triflicacid/remote-submersible/simulations/electromagnet.asc

D1: diode
D2: diode
L1: ind; 10µ
L2: ind; 10µ
M1: nmos; SiR416DP
M2: nmos; SiR470DP
M3: nmos; SiR470DP
R1: res; 100k
R2: res; 1k
R3: res; 10
V1: voltage; PULSE(0 3.3 0 0 0 0.5 1)
V2: voltage; 3.3
V3: voltage; 6
V4: voltage; PULSE(0 3.3 0 0 0 0.5 1)
Named nets: 0
.tran 0 10 0 0.01
