triflicacid/remote-submersible/schematics/on-board-controller/controller.kicad_pcb

## KiCad design schematics/on-board-controller/controller.kicad_pcb (2024-08-15)

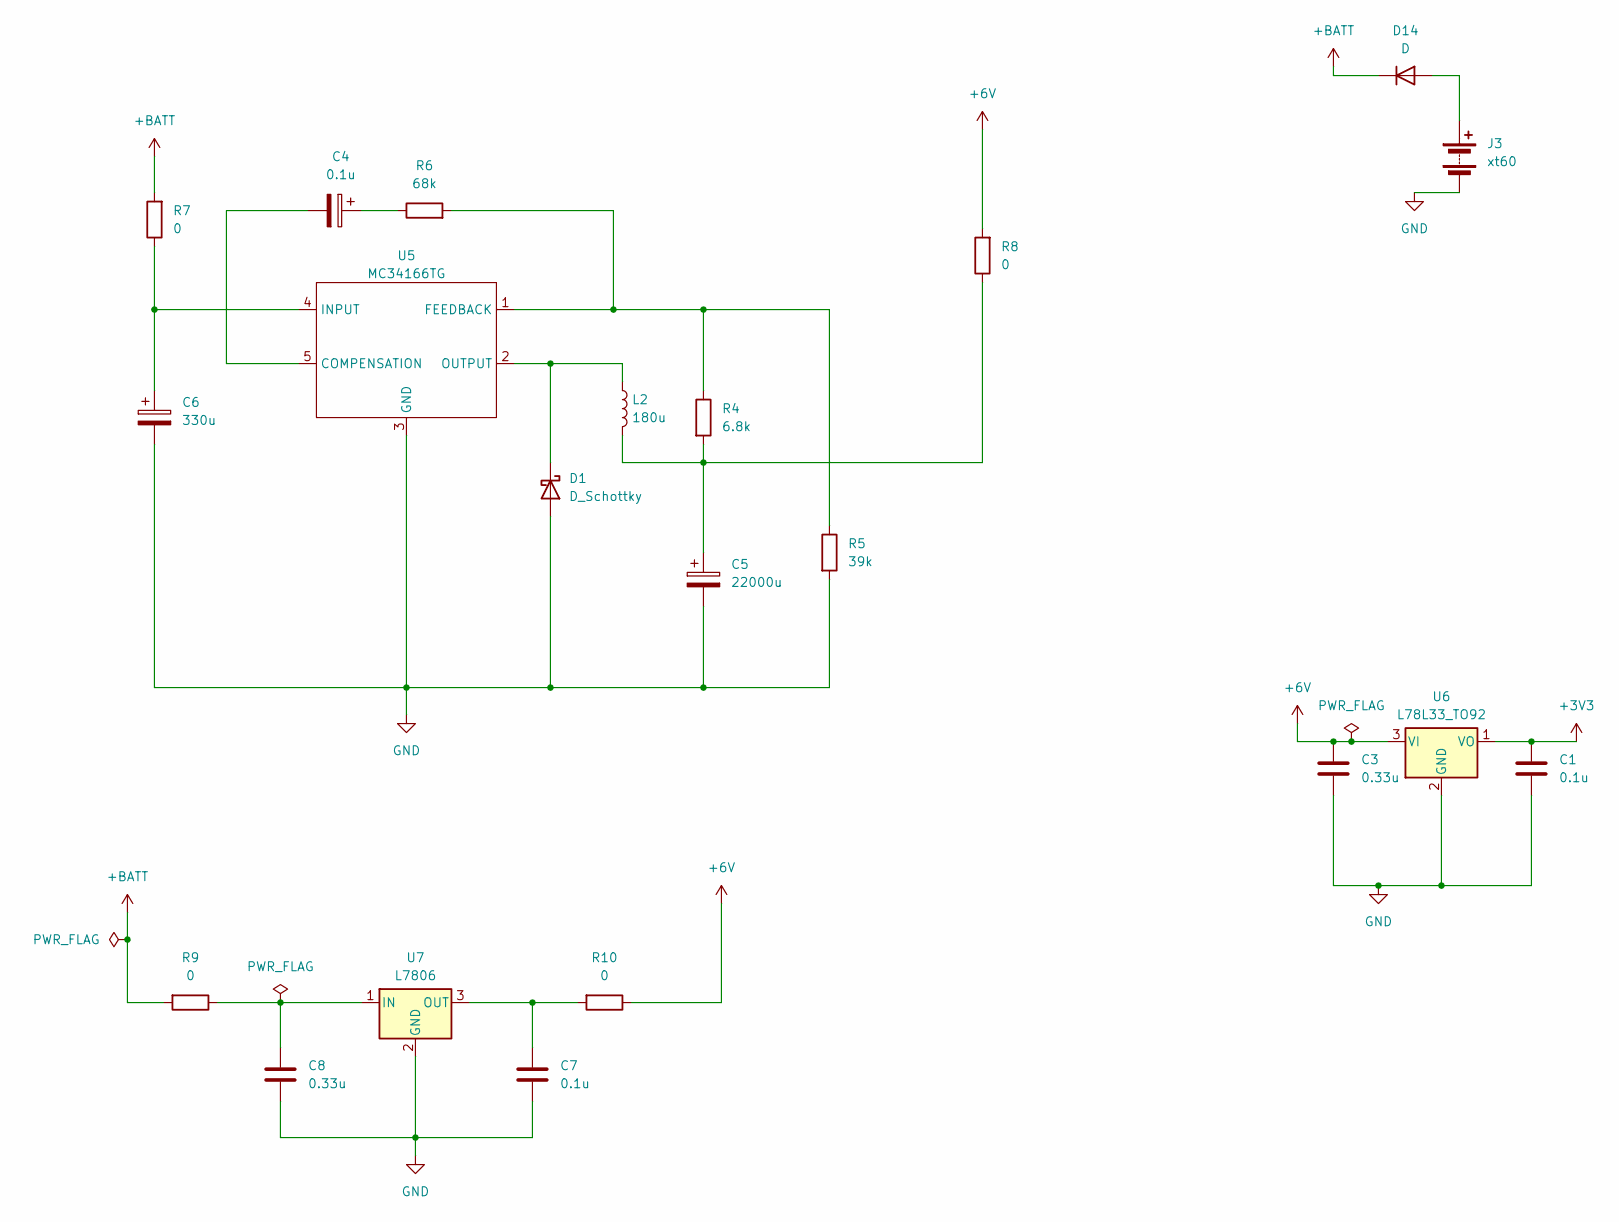
[picture p1: schematic power.kicad_sch, On-board Controller]

Parts:
C1, C7: 0.1u; C_0805_2012Metric_Pad1.18x1.45mm_HandSolder
C3, C8: 0.33u; C_0805_2012Metric_Pad1.18x1.45mm_HandSolder
C4: 0.1u; CP_Radial_D5.0mm_P2.00mm
C5: 22000u; CP_Radial_D18.0mm_P7.50mm
C6: 330u; CP_Radial_D8.0mm_P3.50mm
D1: D_Schottky; D_SOD-128
D14: D; D_A-405_P7.62mm_Horizontal
J3: xt60; PinSocket_1x02_P2.54mm_Vertical
L2: 180u; L_Bourns_SRR1208_12.7x12.7mm
R4: 6.8k; R_0805_2012Metric_Pad1.20x1.40mm_HandSolder
R5: 39k; R_0805_2012Metric_Pad1.20x1.40mm_HandSolder
R6: 68k; R_0805_2012Metric_Pad1.20x1.40mm_HandSolder
R7, R8, R9, R10: 0; R_0805_2012Metric_Pad1.20x1.40mm_HandSolder
U5: MC34166TG; TO-220-5_Vertical
U6: L78L33_TO92; TO-92_Inline
U7: L7806; TO-220-3_Vertical

Connections:
+3V3: C1.1, U6.1 (VO); also elsewhere on the board
+6V: C3.1, R8.2, R10.1, U6.3 (VI); also elsewhere on the board
+BATT: D14.1 (K), R7.2, R9.2; also elsewhere on the board
GND: C1.2, C3.2, C5.2, C6.2, C7.2, C8.2, D1.2 (A), J3.2 (-), R5.2, U5.3 (GND), U6.2 (GND), U7.2 (GND); also elsewhere on the board
unnamed: C4.1, R6.1
unnamed: C5.1, L2.2, R4.2, R8.1
unnamed: D1.1 (K), L2.1, U5.2 (OUTPUT)
unnamed: D14.2 (A), J3.1 (+)
unnamed: C4.2, U5.5 (COMPENSATION)
unnamed: R4.1, R5.1, R6.2, U5.1 (FEEDBACK)
unnamed: C6.1, R7.1, U5.4 (INPUT)
unnamed: C8.1, R9.1, U7.1 (IN)
unnamed: C7.1, R10.2, U7.3 (OUT)

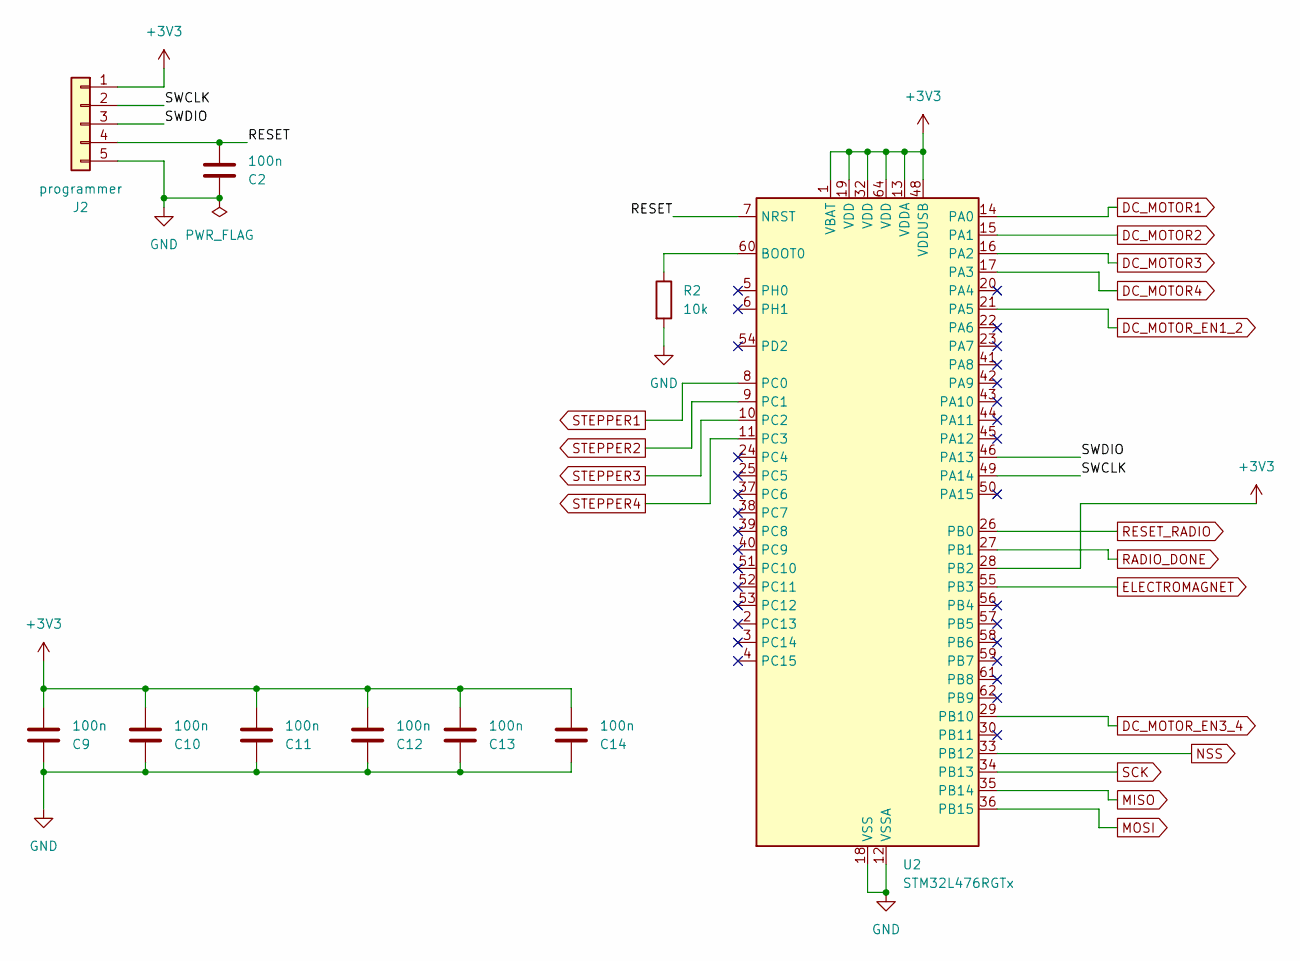
[picture p2: schematic mcu.kicad_sch, On-board Controller]

Parts:
C2, C9, C10, C11, C12, C13, C14: 100n; C_0805_2012Metric_Pad1.18x1.45mm_HandSolder
J2: programmer; PinSocket_1x05_P2.54mm_Vertical
R2: 10k; R_0805_2012Metric_Pad1.20x1.40mm_HandSolder
U2: STM32L476RGTx; LQFP-64_10x10mm_P0.5mm

Connections:
+3V3: C9.2, C10.2, C11.2, C12.2, C13.2, C14.2, J2.1, U2.1 (VBAT), U2.13 (VDDA), U2.19 (VDD), U2.28 (PB2), U2.32 (VDD), U2.48 (VDDUSB), U2.64 (VDD); also elsewhere on the board
/mcu/RESET: C2.2, J2.4, U2.7 (NRST)
/mcu/SWCLK: J2.2, U2.49 (PA14)
/mcu/SWDIO: J2.3, U2.46 (PA13)
DC_MOTOR1: U2.14 (PA0); also elsewhere on the board
DC_MOTOR2: U2.15 (PA1); also elsewhere on the board
DC_MOTOR3: U2.16 (PA2); also elsewhere on the board
DC_MOTOR4: U2.17 (PA3); also elsewhere on the board
DC_MOTOR_EN1_2: U2.21 (PA5); also elsewhere on the board
DC_MOTOR_EN3_4: U2.29 (PB10); also elsewhere on the board
ELECTROMAGNET: U2.55 (PB3); also elsewhere on the board
GND: C2.1, C9.1, C10.1, C11.1, C12.1, C13.1, C14.1, J2.5, R2.2, U2.12 (VSSA), U2.18 (VSS), U2.31 (VSS), U2.47 (VSS), U2.63 (VSS); also elsewhere on the board
MISO: U2.35 (PB14); also elsewhere on the board
MOSI: U2.36 (PB15); also elsewhere on the board
NSS: U2.33 (PB12); also elsewhere on the board
unnamed: R2.1, U2.60 (BOOT0)
RADIO_DONE: U2.27 (PB1); also elsewhere on the board
RESET_RADIO: U2.26 (PB0); also elsewhere on the board
SCK: U2.34 (PB13); also elsewhere on the board
STEPPER1: U2.8 (PC0); also elsewhere on the board
STEPPER2: U2.9 (PC1); also elsewhere on the board
STEPPER3: U2.10 (PC2); also elsewhere on the board
STEPPER4: U2.11 (PC3); also elsewhere on the board

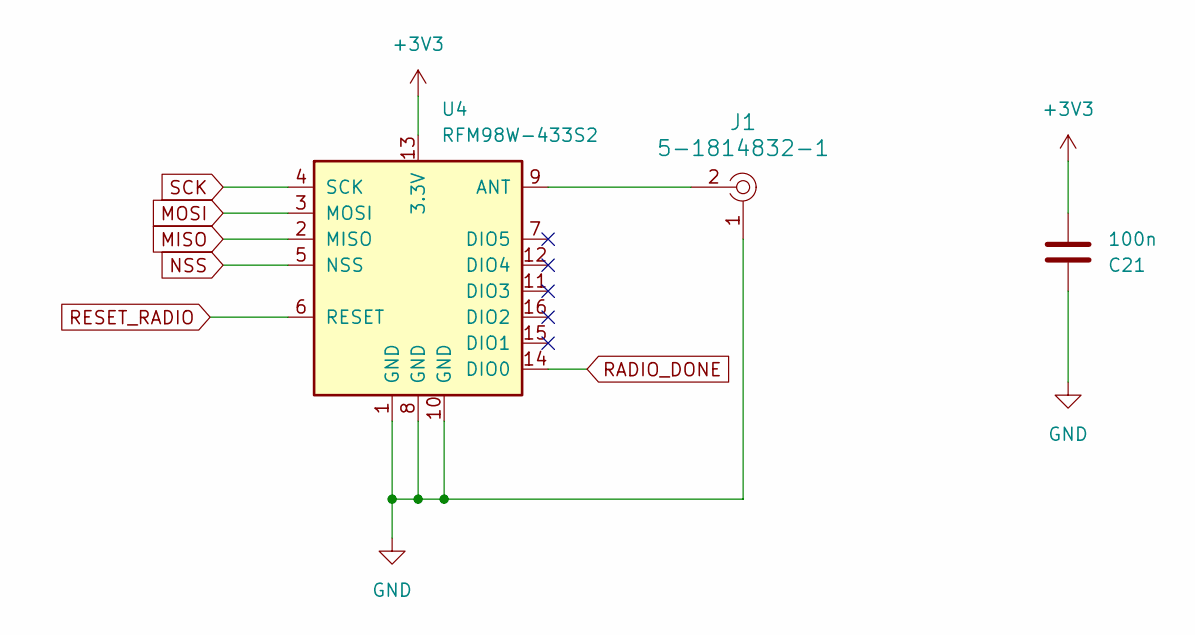
[picture p3: schematic radio.kicad_sch, On-board Controller]

Parts:
C21: 100n; C_0805_2012Metric_Pad1.18x1.45mm_HandSolder
J1: 5-1814832-1; RF_SMA_Vertical_5-1814832-1; MPN 5-1814832-1; Digi-Key_PN A97594-ND
U4: RFM98W-433S2; HOPERF_RFM9XW_THT

Connections:
+3V3: C21.2, U4.13 (3.3V); also elsewhere on the board
GND: C21.1, J1.1, U4.1 (GND), U4.8 (GND), U4.10 (GND); also elsewhere on the board
MISO: U4.2 (MISO); also elsewhere on the board
MOSI: U4.3 (MOSI); also elsewhere on the board
NSS: U4.5 (NSS); also elsewhere on the board
unnamed: J1.2, U4.9 (ANT)
RADIO_DONE: U4.14 (DIO0); also elsewhere on the board
RESET_RADIO: U4.6 (RESET); also elsewhere on the board
SCK: U4.4 (SCK); also elsewhere on the board

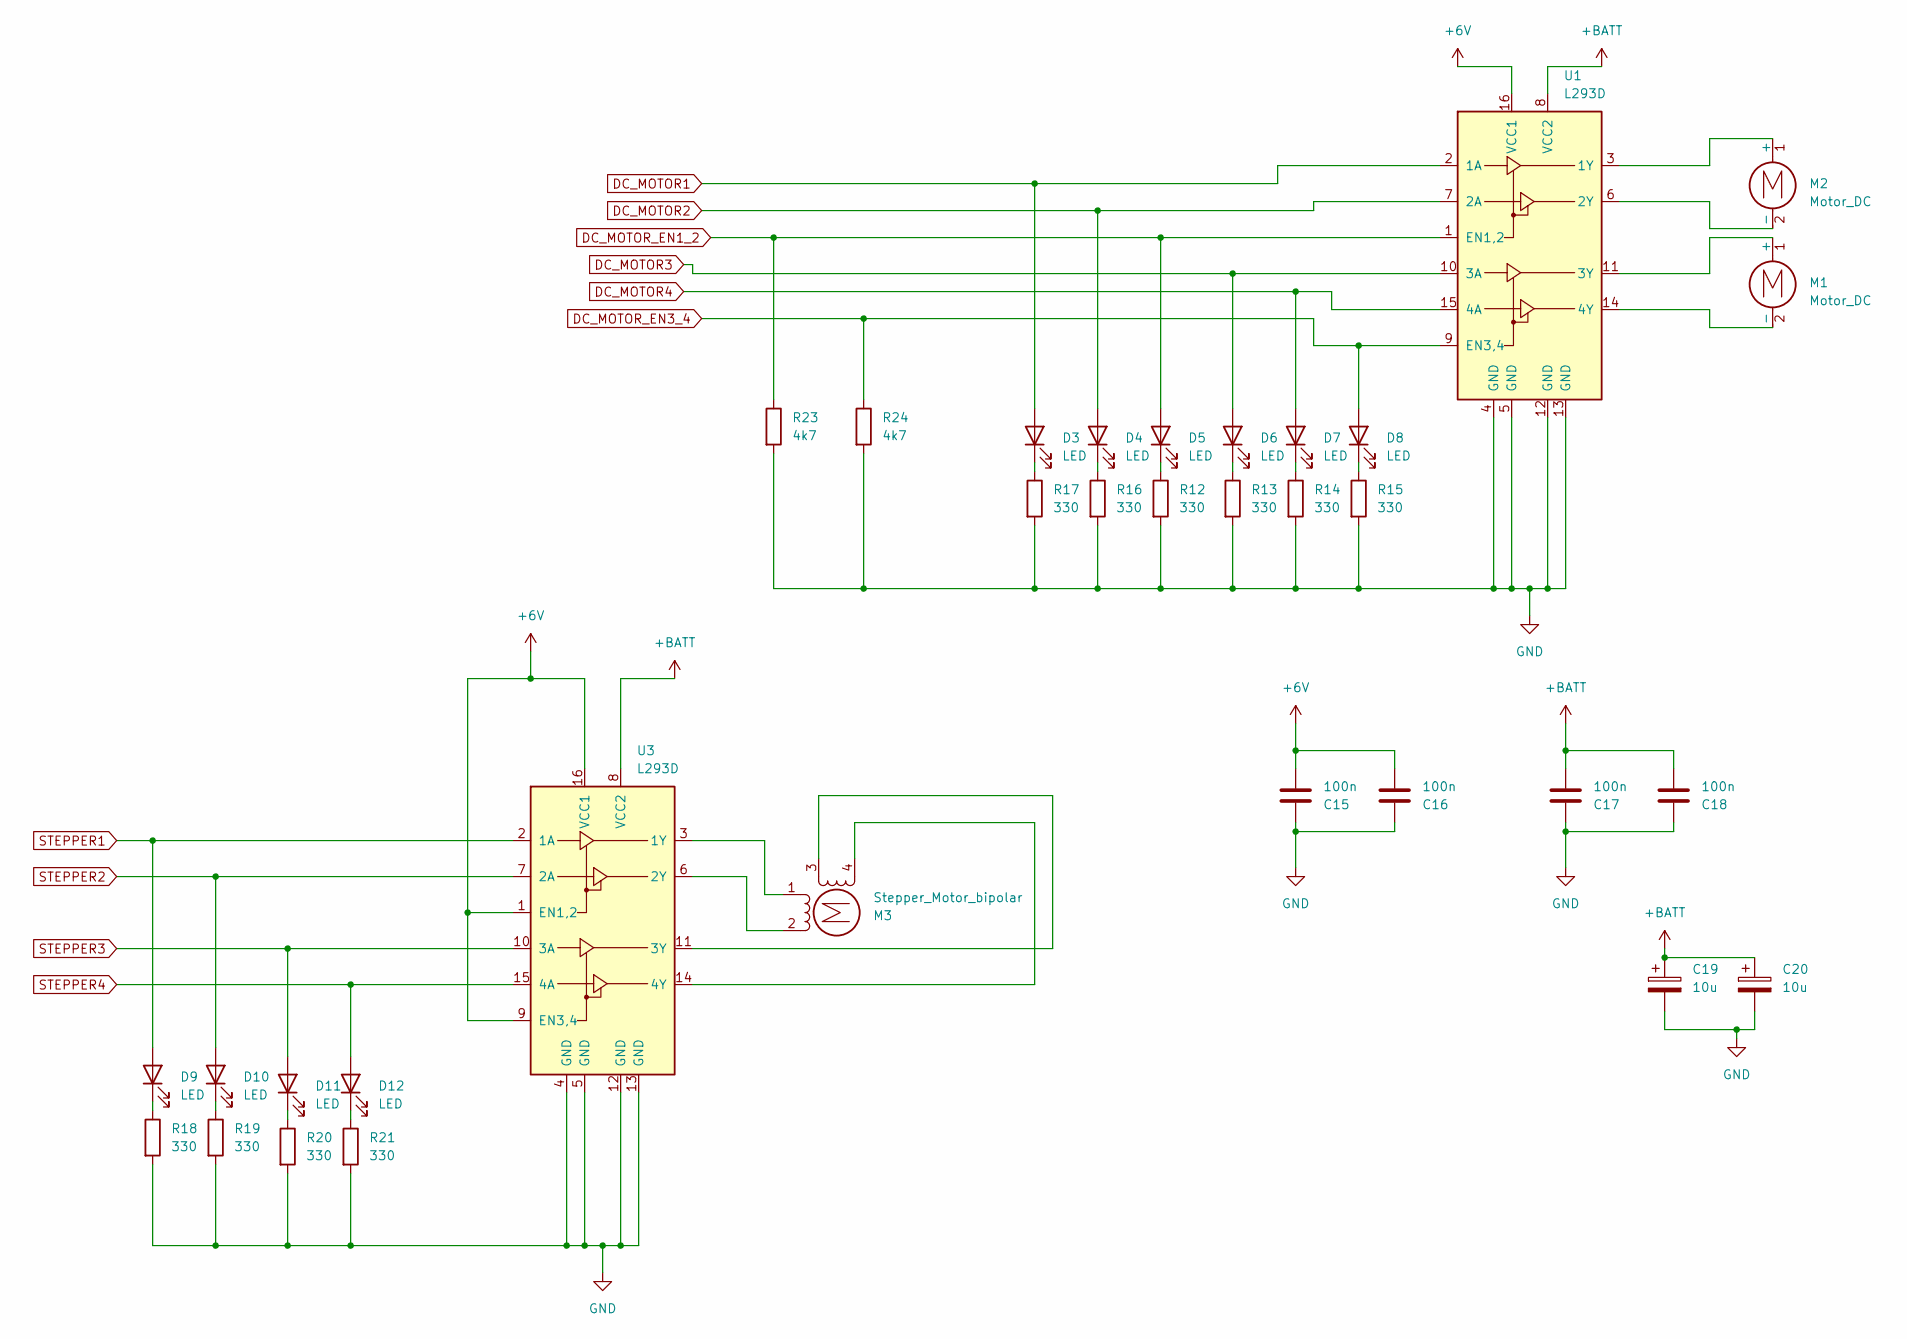
[picture p4: schematic motor.kicad_sch, On-board Controller]

Parts:
C15, C16, C17, C18: 100n; C_0805_2012Metric_Pad1.18x1.45mm_HandSolder
C19, C20: 10u; CP_Radial_D5.0mm_P2.00mm
D3, D4, D5, D6, D7, D8, D9, D10, D11, D12: LED; LED_0805_2012Metric_Pad1.15x1.40mm_HandSolder
M1, M2: Motor_DC; TerminalBlock_Xinya_XY308-2.54-2P_1x02_P2.54mm_Horizontal
M3: Stepper_Motor_bipolar; PinSocket_1x04_P2.54mm_Vertical
R12, R13, R14, R15, R16, R17, R18, R19, R20, R21: 330; R_0805_2012Metric_Pad1.20x1.40mm_HandSolder
R23, R24: 4k7; R_0805_2012Metric_Pad1.20x1.40mm_HandSolder
U1, U3: L293D; DIP-16_W7.62mm

Connections:
+6V: C15.2, C16.2, U1.16 (VCC1), U3.1 (EN1,2), U3.9 (EN3,4), U3.16 (VCC1); also elsewhere on the board
+BATT: C17.2, C18.2, C19.1, C20.1, U1.8 (VCC2), U3.8 (VCC2); also elsewhere on the board
DC_MOTOR1: D3.2 (A), U1.2 (1A); also elsewhere on the board
DC_MOTOR2: D4.2 (A), U1.7 (2A); also elsewhere on the board
DC_MOTOR3: D6.2 (A), U1.10 (3A); also elsewhere on the board
DC_MOTOR4: D7.2 (A), U1.15 (4A); also elsewhere on the board
DC_MOTOR_EN1_2: D5.2 (A), R23.1, U1.1 (EN1,2); also elsewhere on the board
DC_MOTOR_EN3_4: D8.2 (A), R24.1, U1.9 (EN3,4); also elsewhere on the board
GND: C15.1, C16.1, C17.1, C18.1, C19.2, C20.2, R12.2, R13.2, R14.2, R15.2, R16.2, R17.2, R18.2, R19.2, R20.2, R21.2, R23.2, R24.2, U1.4 (GND), U1.5 (GND), U1.12 (GND), U1.13 (GND), U3.4 (GND), U3.5 (GND), U3.12 (GND), U3.13 (GND); also elsewhere on the board
unnamed: D3.1 (K), R17.1
unnamed: D4.1 (K), R16.1
unnamed: D5.1 (K), R12.1
unnamed: D6.1 (K), R13.1
unnamed: D7.1 (K), R14.1
unnamed: D8.1 (K), R15.1
unnamed: D9.1 (K), R18.1
unnamed: D10.1 (K), R19.1
unnamed: D11.1 (K), R20.1
unnamed: D12.1 (K), R21.1
unnamed: M1.1 (+), U1.11 (3Y)
unnamed: M1.2 (-), U1.14 (4Y)
unnamed: M2.1 (+), U1.3 (1Y)
unnamed: M2.2 (-), U1.6 (2Y)
unnamed: M3.2 (-), U3.6 (2Y)
unnamed: M3.1, U3.3 (1Y)
unnamed: M3.3, U3.11 (3Y)
unnamed: M3.4, U3.14 (4Y)
STEPPER1: D9.2 (A), U3.2 (1A); also elsewhere on the board
STEPPER2: D10.2 (A), U3.7 (2A); also elsewhere on the board
STEPPER3: D11.2 (A), U3.10 (3A); also elsewhere on the board
STEPPER4: D12.2 (A), U3.15 (4A); also elsewhere on the board

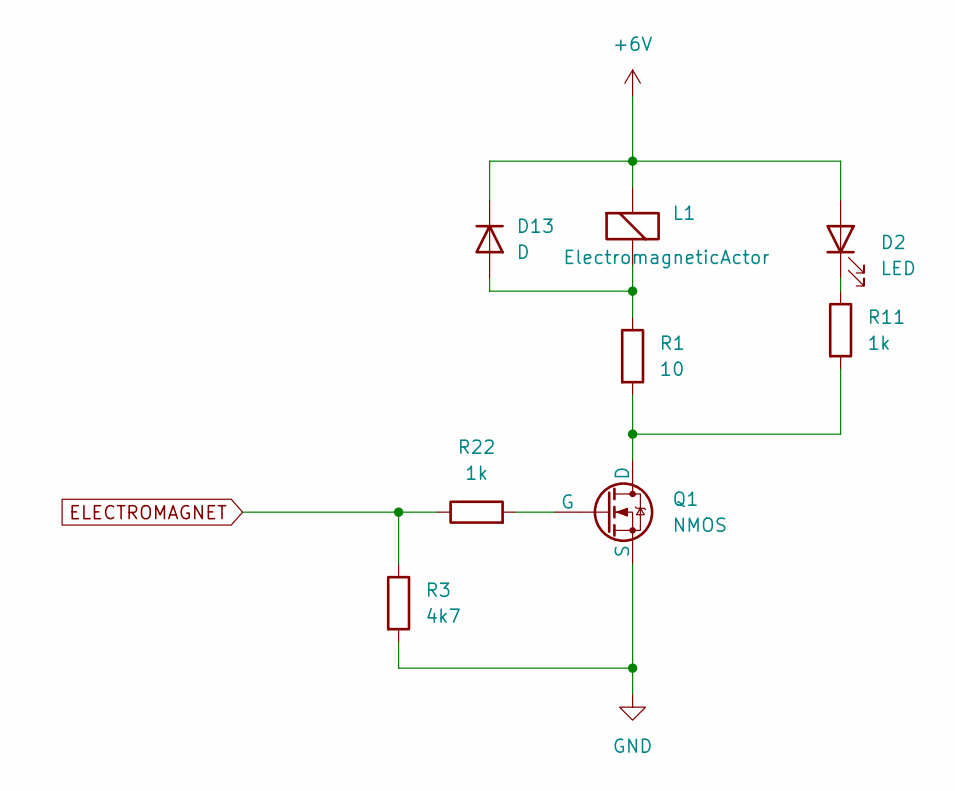
[picture p5: schematic electromagnet.kicad_sch, On-board Controller]

Parts:
D2: LED; LED_0805_2012Metric_Pad1.15x1.40mm_HandSolder
D13: D; D_A-405_P7.62mm_Horizontal
L1: ElectromagneticActor; TerminalBlock_Xinya_XY308-2.54-2P_1x02_P2.54mm_Horizontal
Q1: NMOS; TO-92_Inline
R1: 10; R_0805_2012Metric_Pad1.20x1.40mm_HandSolder
R3: 4k7; R_0805_2012Metric_Pad1.20x1.40mm_HandSolder
R11, R22: 1k; R_0805_2012Metric_Pad1.20x1.40mm_HandSolder

Connections:
+6V: D2.2 (A), D13.1 (K), L1.1 (-); also elsewhere on the board
ELECTROMAGNET: R3.1, R22.1; also elsewhere on the board
GND: Q1.3 (S), R3.2; also elsewhere on the board
unnamed: D2.1 (K), R11.1
unnamed: D13.2 (A), L1.2 (+), R1.1
unnamed: Q1.1 (D), R1.2, R11.2
unnamed: Q1.2 (G), R22.2

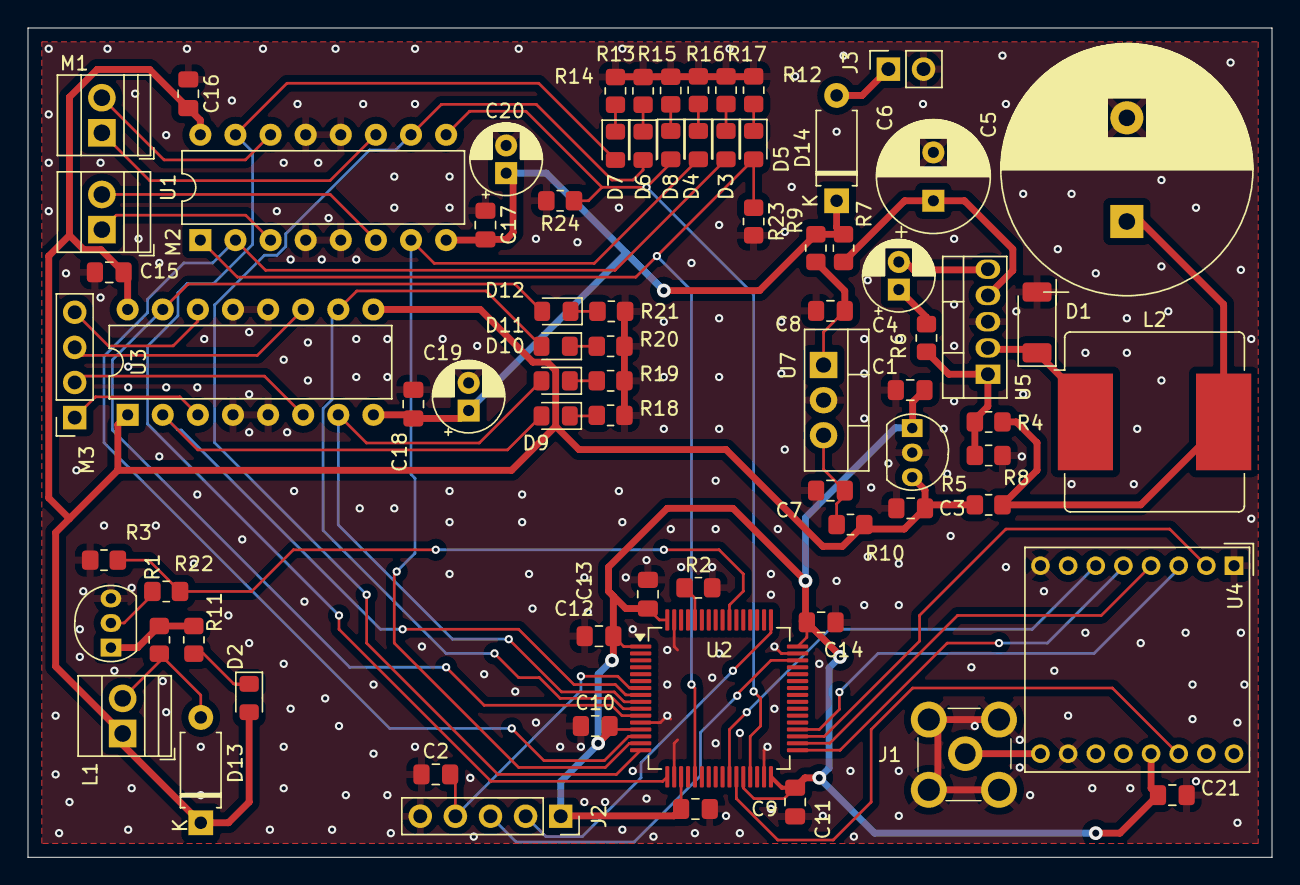
[picture p6: board schematics/on-board-controller/controller.kicad_pcb from above]

Board: 2 copper layers, 90.0 x 60.0 mm, 75 parts (0 on the bottom side), 57 nets.
