triflicacid/remote-submersible/schematics/off-board-controller/controller.kicad_pcb

## KiCad design schematics/off-board-controller/controller.kicad_pcb (2024-08-29)

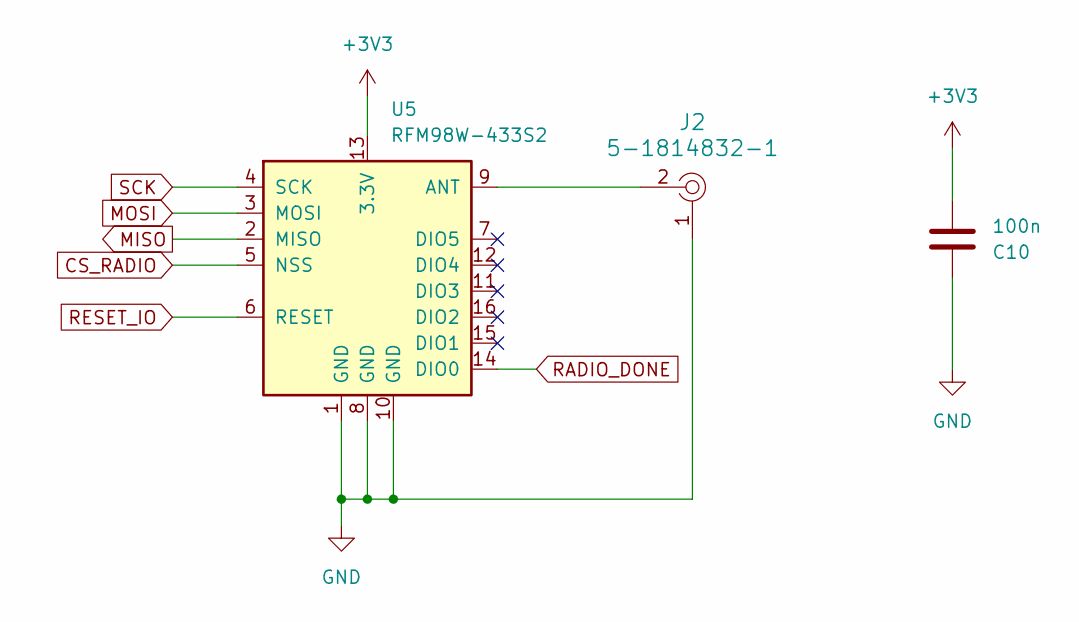
[picture p7: schematic radio.kicad_sch, Off-board Controller]

Parts:
C10: 100n; C_0805_2012Metric_Pad1.18x1.45mm_HandSolder
J2: 5-1814832-1; RF_SMA_Vertical_5-1814832-1; MPN 5-1814832-1; Digi-Key_PN A97594-ND
U5: RFM98W-433S2; HOPERF_RFM9XW_THT

Connections:
+3V3: C10.2, U5.13 (3.3V); also elsewhere on the board
CS_RADIO: U5.5 (NSS); also elsewhere on the board
GND: C10.1, J2.1, U5.1 (GND), U5.8 (GND), U5.10 (GND); also elsewhere on the board
MISO: U5.2 (MISO); also elsewhere on the board
MOSI: U5.3 (MOSI); also elsewhere on the board
unnamed: J2.2, U5.9 (ANT)
RADIO_DONE: U5.14 (DIO0); also elsewhere on the board
RESET_IO: U5.6 (RESET); also elsewhere on the board
SCK: U5.4 (SCK); also elsewhere on the board

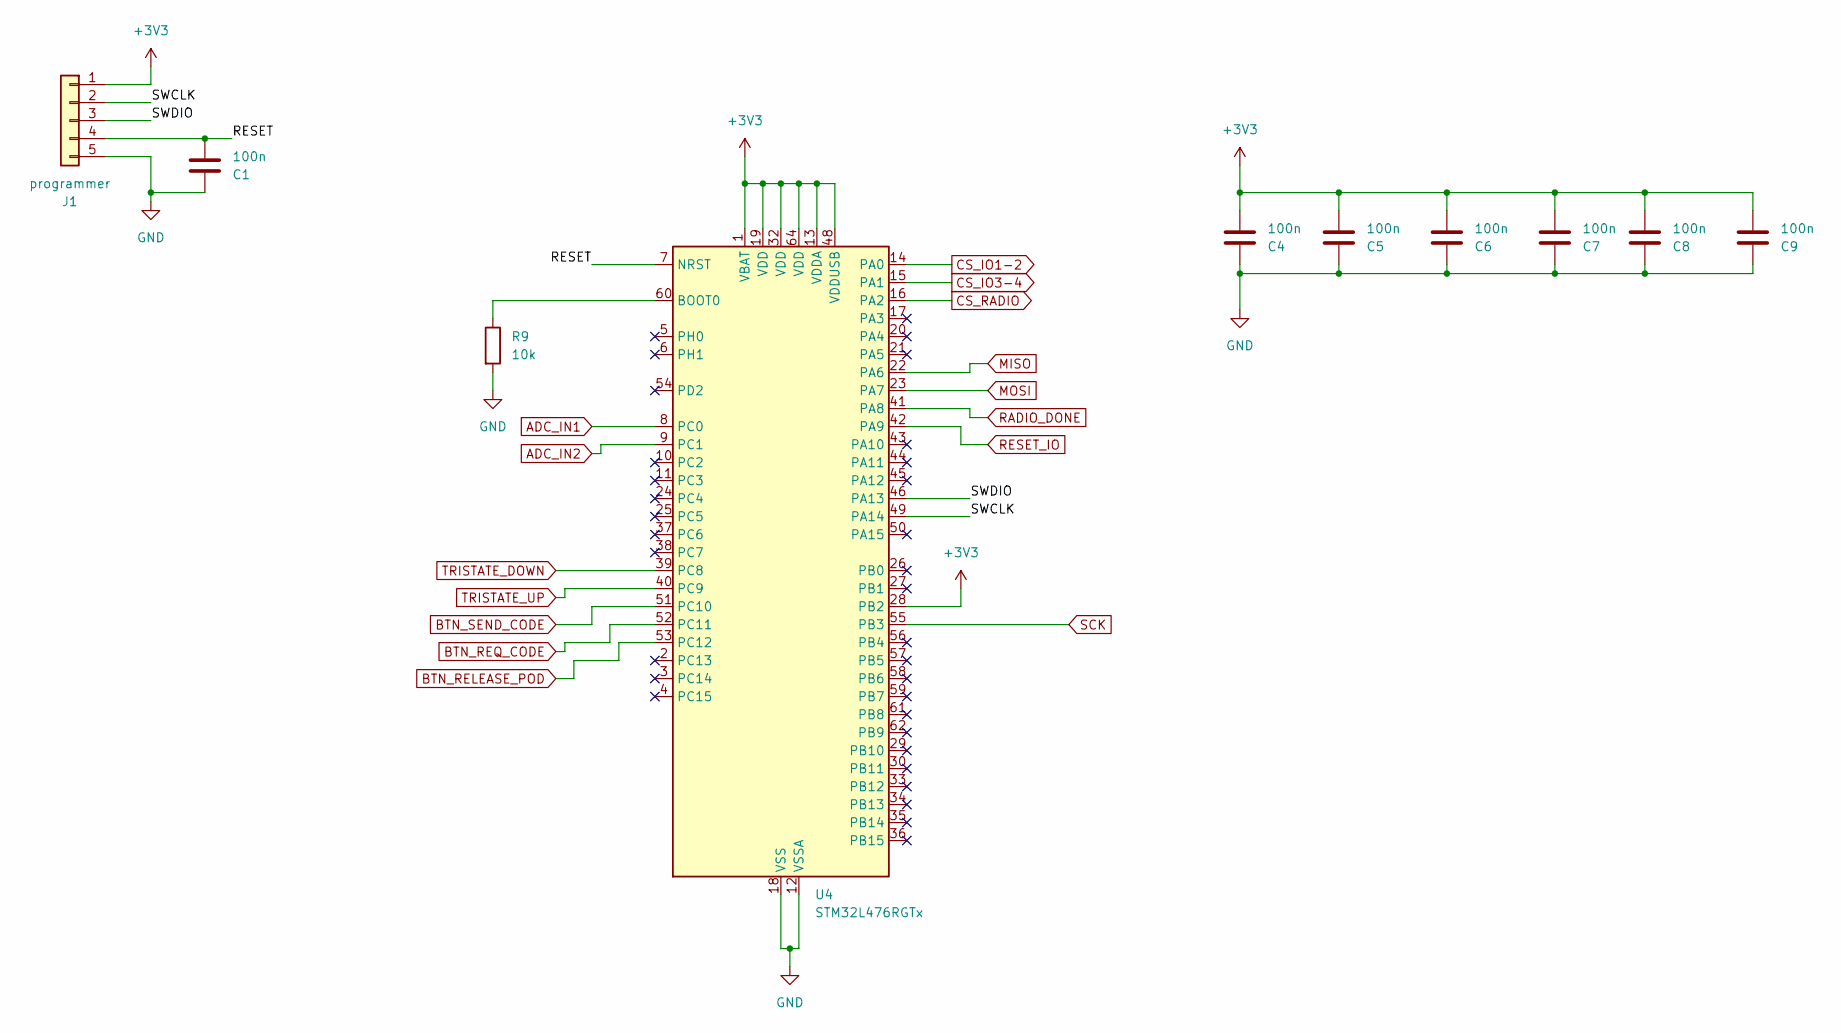
[picture p8: schematic mcu.kicad_sch, Off-board Controller]

Parts:
C1, C4, C5, C6, C7, C8, C9: 100n; C_0805_2012Metric_Pad1.18x1.45mm_HandSolder
J1: programmer; PinSocket_1x05_P2.54mm_Vertical
R9: 10k; R_0805_2012Metric_Pad1.20x1.40mm_HandSolder
U4: STM32L476RGTx; LQFP-64_10x10mm_P0.5mm

Connections:
+3V3: C4.2, C5.2, C6.2, C7.2, C8.2, C9.2, J1.1, U4.1 (VBAT), U4.13 (VDDA), U4.19 (VDD), U4.28 (PB2), U4.32 (VDD), U4.48 (VDDUSB), U4.64 (VDD); also elsewhere on the board
/mcu/RESET: C1.2, J1.4, U4.7 (NRST)
/mcu/SWCLK: J1.2, U4.49 (PA14)
/mcu/SWDIO: J1.3, U4.46 (PA13)
ADC_IN1: U4.8 (PC0); also elsewhere on the board
ADC_IN2: U4.9 (PC1); also elsewhere on the board
BTN_RELEASE_POD: U4.53 (PC12); also elsewhere on the board
BTN_REQ_CODE: U4.52 (PC11); also elsewhere on the board
BTN_SEND_CODE: U4.51 (PC10); also elsewhere on the board
CS_IO1-2: U4.14 (PA0); also elsewhere on the board
CS_IO3-4: U4.15 (PA1); also elsewhere on the board
CS_RADIO: U4.16 (PA2); also elsewhere on the board
GND: C1.1, C4.1, C5.1, C6.1, C7.1, C8.1, C9.1, J1.5, R9.2, U4.12 (VSSA), U4.18 (VSS), U4.31 (VSS), U4.47 (VSS), U4.63 (VSS); also elsewhere on the board
MISO: U4.22 (PA6); also elsewhere on the board
MOSI: U4.23 (PA7); also elsewhere on the board
unnamed: R9.1, U4.60 (BOOT0)
RADIO_DONE: U4.41 (PA8); also elsewhere on the board
RESET_IO: U4.42 (PA9); also elsewhere on the board
SCK: U4.55 (PB3); also elsewhere on the board
TRISTATE_DOWN: U4.39 (PC8); also elsewhere on the board
TRISTATE_UP: U4.40 (PC9); also elsewhere on the board

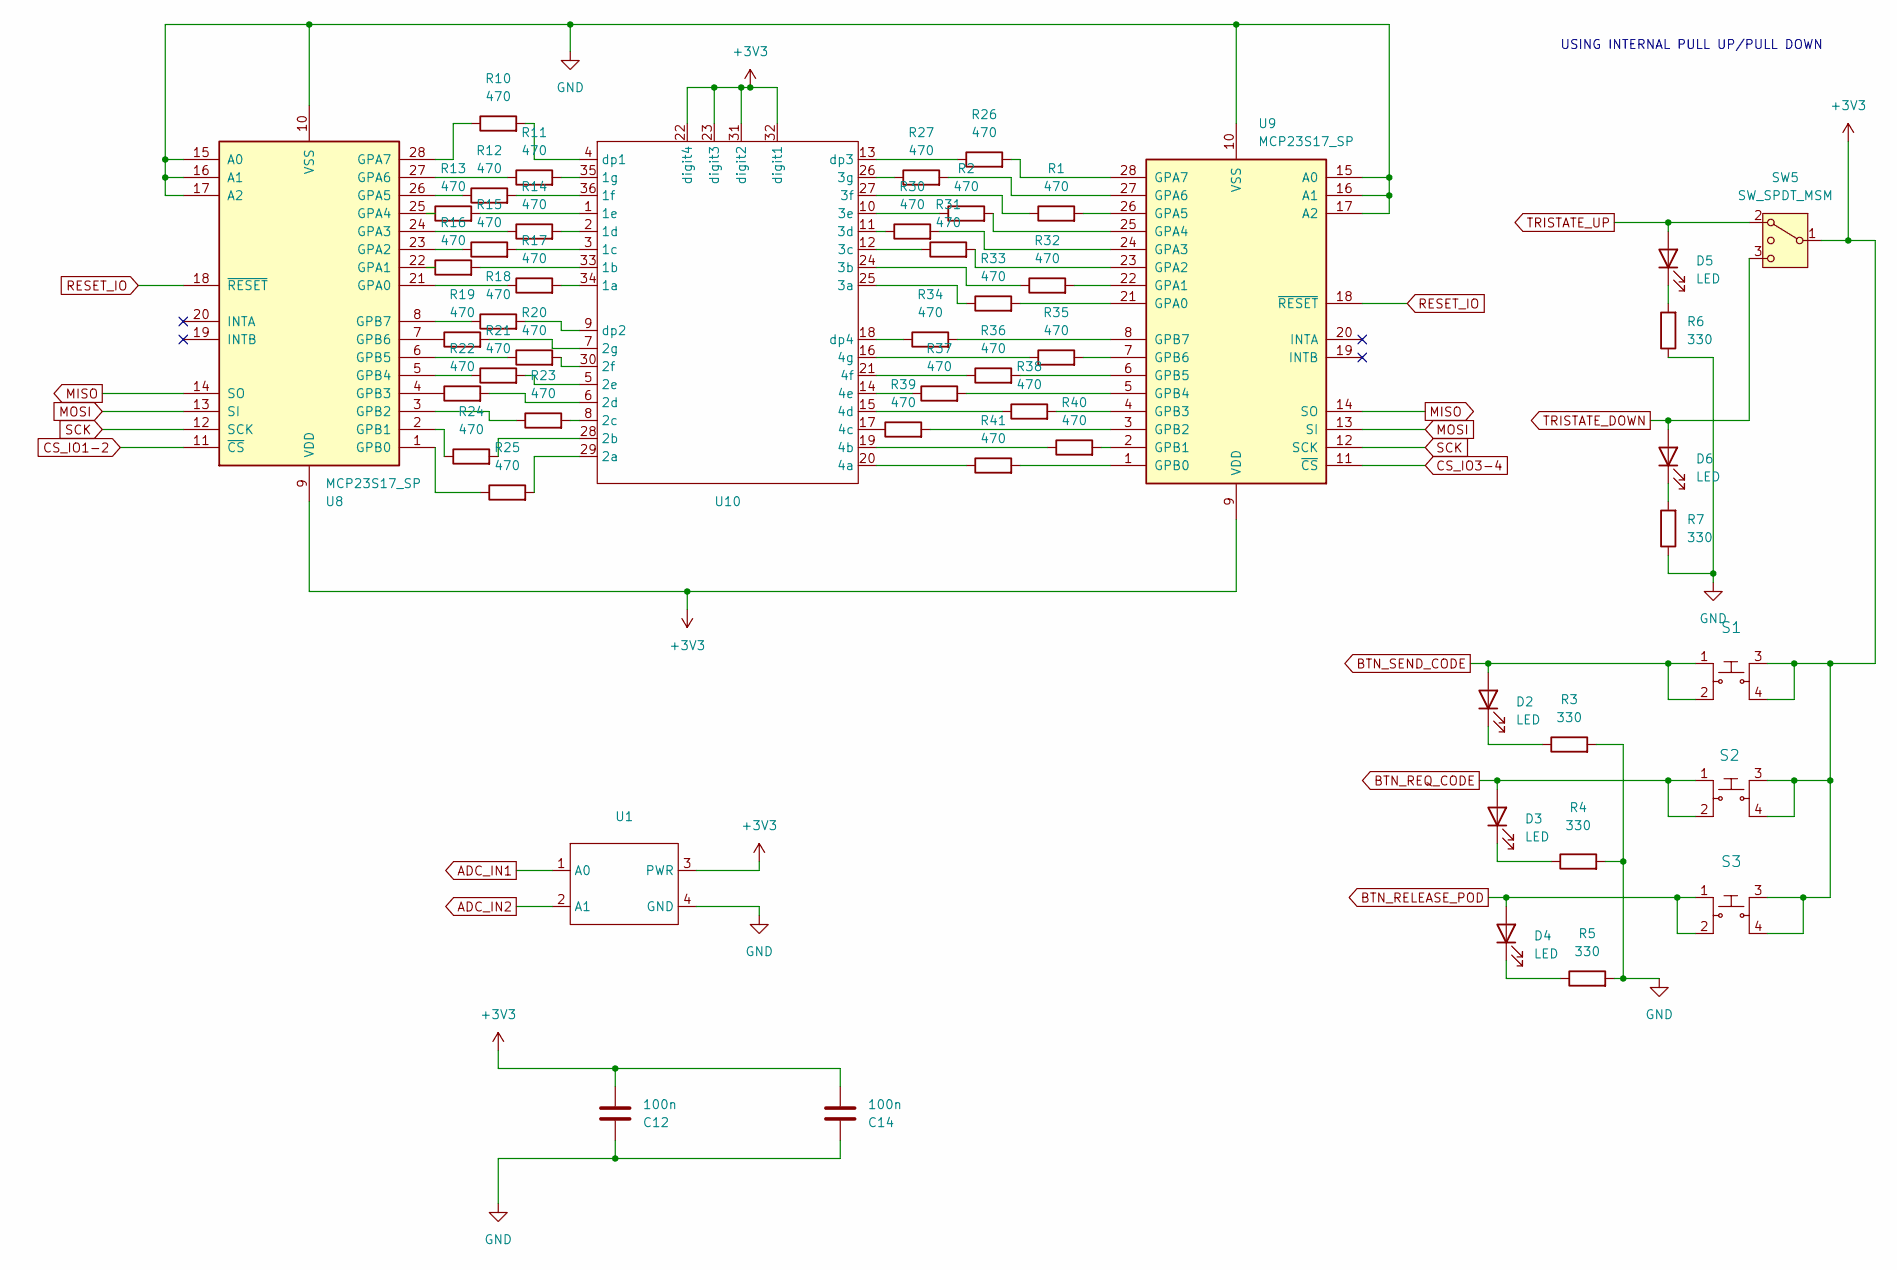
[picture p9: schematic io.kicad_sch, Off-board Controller]

Parts:
C12, C14: 100n; C_0805_2012Metric_Pad1.18x1.45mm_HandSolder
D2, D3, D4, D5, D6: LED; LED_0805_2012Metric_Pad1.15x1.40mm_HandSolder
R1, R2, R10, R11, R12, R13, R14, R15, R16, R17, R18, R19, R20, R21, R22, R23, R24, R25, R26, R27, R30, R31, R32, R33, R34, R35, R36, R37, R38, R39, R40, R41: 470; R_0805_2012Metric_Pad1.20x1.40mm_HandSolder
R3, R4, R5, R6, R7: 330; R_0805_2012Metric_Pad1.20x1.40mm_HandSolder
S1, S2, S3: button; MPN 1825910-6; Digi-Key_PN 450-1650-ND
SW5: SW_SPDT_MSM; spdt
U1: NS-Tech_Grove_1x04_P2mm_Vertical
U8, U9: MCP23S17_SP; DIP-28_W7.62mm
U10: seven_segment

Connections:
+3V3: C12.2, C14.2, S1.3, S1.4, S2.3, S2.4, S3.3, S3.4, SW5.1 (3), U1.3 (PWR), U8.9 (VDD), U9.9 (VDD), U10.22 (digit4), U10.23 (digit3), U10.31 (digit2), U10.32 (digit1); also elsewhere on the board
ADC_IN1: U1.1 (A0); also elsewhere on the board
ADC_IN2: U1.2 (A1); also elsewhere on the board
BTN_RELEASE_POD: D4.2 (A), S3.1, S3.2; also elsewhere on the board
BTN_REQ_CODE: D3.2 (A), S2.1, S2.2; also elsewhere on the board
BTN_SEND_CODE: D2.2 (A), S1.1, S1.2; also elsewhere on the board
CS_IO1-2: U8.11 (~CS); also elsewhere on the board
CS_IO3-4: U9.11 (~CS); also elsewhere on the board
GND: C12.1, C14.1, R3.2, R4.2, R5.2, R6.1, R7.1, U1.4 (GND), U8.10 (VSS), U8.15 (A0), U8.16 (A1), U8.17 (A2), U9.10 (VSS), U9.15 (A0), U9.16 (A1), U9.17 (A2); also elsewhere on the board
MISO: U8.14 (SO), U9.14 (SO); also elsewhere on the board
MOSI: U8.13 (SI), U9.13 (SI); also elsewhere on the board
unnamed: D2.1 (K), R3.1
unnamed: D3.1 (K), R4.1
unnamed: D4.1 (K), R5.1
unnamed: D5.1 (K), R6.2
unnamed: D6.1 (K), R7.2
unnamed: R17.1, U8.21 (GPA0)
unnamed: R16.1, U8.22 (GPA1)
unnamed: R15.1, U8.23 (GPA2)
unnamed: R14.1, U8.24 (GPA3)
unnamed: R13.1, U8.25 (GPA4)
unnamed: R12.1, U8.26 (GPA5)
unnamed: R11.1, U8.27 (GPA6)
unnamed: R10.1, U8.28 (GPA7)
unnamed: R25.1, U8.1 (GPB0)
unnamed: R24.1, U8.2 (GPB1)
unnamed: R23.1, U8.3 (GPB2)
unnamed: R22.1, U8.4 (GPB3)
unnamed: R21.1, U8.5 (GPB4)
unnamed: R20.1, U8.6 (GPB5)
unnamed: R19.1, U8.7 (GPB6)
unnamed: R18.1, U8.8 (GPB7)
unnamed: R33.2, U9.21 (GPA0)
unnamed: R32.2, U9.22 (GPA1)
unnamed: R31.2, U9.23 (GPA2)
unnamed: R30.2, U9.24 (GPA3)
unnamed: R2.2, U9.25 (GPA4)
unnamed: R1.2, U9.26 (GPA5)
unnamed: R27.2, U9.27 (GPA6)
unnamed: R26.2, U9.28 (GPA7)
unnamed: R41.2, U9.1 (GPB0)
unnamed: R40.2, U9.2 (GPB1)
unnamed: R39.2, U9.3 (GPB2)
unnamed: R38.2, U9.4 (GPB3)
unnamed: R37.2, U9.5 (GPB4)
unnamed: R36.2, U9.6 (GPB5)
unnamed: R35.2, U9.7 (GPB6)
unnamed: R34.2, U9.8 (GPB7)
unnamed: R17.2, U10.34 (1a)
unnamed: R16.2, U10.33 (1b)
unnamed: R15.2, U10.3 (1c)
unnamed: R14.2, U10.2 (1d)
unnamed: R13.2, U10.1 (1e)
unnamed: R12.2, U10.36 (1f)
unnamed: R11.2, U10.35 (1g)
unnamed: R25.2, U10.29 (2a)
unnamed: R24.2, U10.28 (2b)
unnamed: R23.2, U10.8 (2c)
unnamed: R22.2, U10.6 (2d)
unnamed: R21.2, U10.5 (2e)
unnamed: R20.2, U10.30 (2f)
unnamed: R19.2, U10.7 (2g)
unnamed: R33.1, U10.25 (3a)
unnamed: R32.1, U10.24 (3b)
unnamed: R31.1, U10.12 (3c)
unnamed: R30.1, U10.11 (3d)
unnamed: R2.1, U10.10 (3e)
unnamed: R1.1, U10.27 (3f)
unnamed: R27.1, U10.26 (3g)
unnamed: R41.1, U10.20 (4a)
unnamed: R40.1, U10.19 (4b)
unnamed: R39.1, U10.17 (4c)
unnamed: R38.1, U10.15 (4d)
unnamed: R37.1, U10.14 (4e)
unnamed: R36.1, U10.21 (4f)
unnamed: R35.1, U10.16 (4g)
unnamed: R10.2, U10.4 (dp1)
unnamed: R18.2, U10.9 (dp2)
unnamed: R26.1, U10.13 (dp3)
unnamed: R34.1, U10.18 (dp4)
RESET_IO: U8.18 (~RESET), U9.18 (~RESET); also elsewhere on the board
SCK: U8.12 (SCK), U9.12 (SCK); also elsewhere on the board
TRISTATE_DOWN: D6.2 (A), SW5.3 (4); also elsewhere on the board
TRISTATE_UP: D5.2 (A), SW5.2 (1); also elsewhere on the board

Notes on the sheet:
USING INTERNAL PULL UP/PULL DOWN

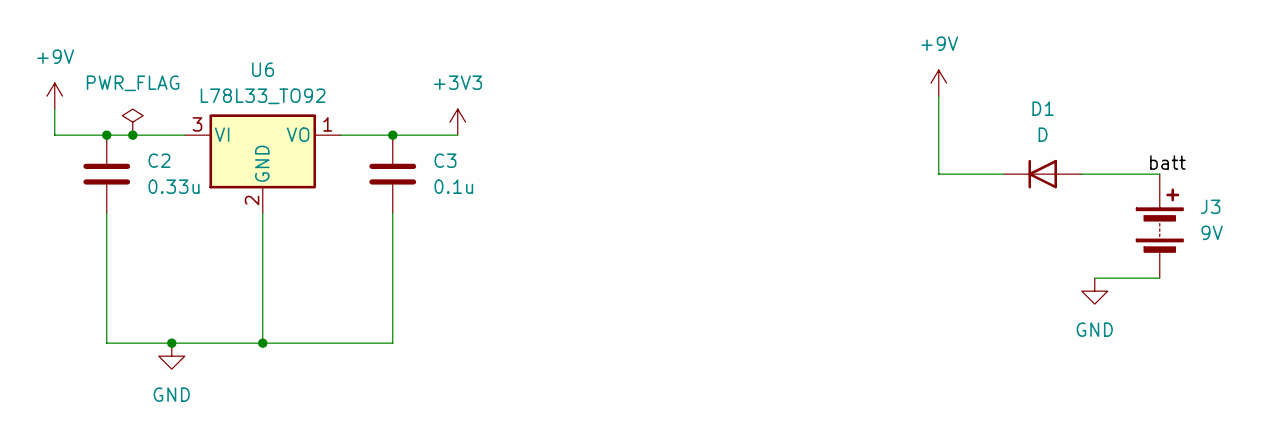
[picture p10: schematic power.kicad_sch, Off-board Controller]

Parts:
C2: 0.33u; C_0805_2012Metric_Pad1.18x1.45mm_HandSolder
C3: 0.1u; C_0805_2012Metric_Pad1.18x1.45mm_HandSolder
D1: D; D_A-405_P7.62mm_Horizontal
J3: 9V; PinSocket_1x02_P2.54mm_Vertical
U6: L78L33_TO92; TO-92_Inline

Connections:
+3V3: C3.1, U6.1 (VO); also elsewhere on the board
+9V: C2.1, D1.1 (K), U6.3 (VI)
/power/batt: D1.2 (A), J3.1 (+)
GND: C2.2, C3.2, J3.2 (-), U6.2 (GND); also elsewhere on the board
