triflicacid/remote-submersible/schematics/off-board-controller/controller.kicad_pcb

## KiCad design schematics/off-board-controller/controller.kicad_pcb (continued)

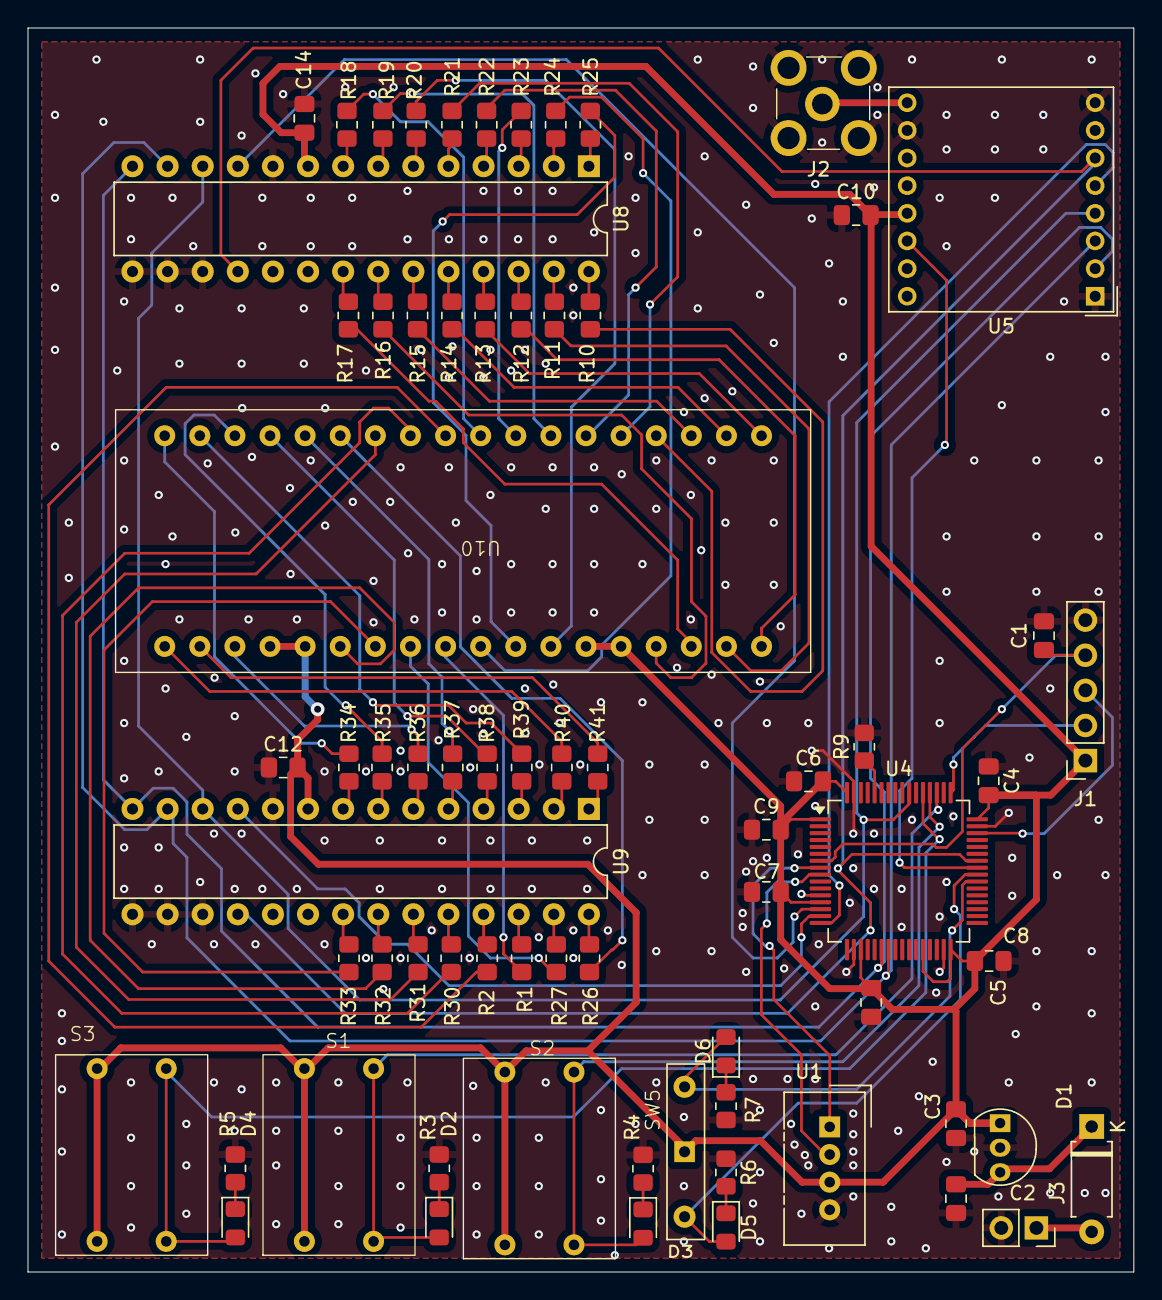
[picture p11: board schematics/off-board-controller/controller.kicad_pcb from above]

Board: 2 copper layers, 80.0 x 90.0 mm, 70 parts (0 on the bottom side), 93 nets.
