triflicacid/remote-submersible/code/on-board/Core/Inc/main.h

#define B1_Pin GPIO_PIN_13
#define B1_GPIO_Port GPIOC
#define B1_EXTI_IRQn EXTI15_10_IRQn
#define STEPPER_BLACK_Pin GPIO_PIN_0
#define STEPPER_BLACK_GPIO_Port GPIOC
#define STEPPER_BLUE_Pin GPIO_PIN_1
#define STEPPER_BLUE_GPIO_Port GPIOC
#define STEPPER_GREEN_Pin GPIO_PIN_2
#define STEPPER_GREEN_GPIO_Port GPIOC
#define STEPPER_RED_Pin GPIO_PIN_3
#define STEPPER_RED_GPIO_Port GPIOC
#define DC_MOTOR_IN1_Pin GPIO_PIN_0
#define DC_MOTOR_IN1_GPIO_Port GPIOA
#define DC_MOTOR_IN2_Pin GPIO_PIN_1
#define DC_MOTOR_IN2_GPIO_Port GPIOA
#define DC_MOTOR_IN3_Pin GPIO_PIN_2
#define DC_MOTOR_IN3_GPIO_Port GPIOA
#define DC_MOTOR_IN4_Pin GPIO_PIN_3
#define DC_MOTOR_IN4_GPIO_Port GPIOA
#define DC_MOTOR_EN1_2_Pin GPIO_PIN_5
#define DC_MOTOR_EN1_2_GPIO_Port GPIOA
#define RFM_RESET_Pin GPIO_PIN_0
#define RFM_RESET_GPIO_Port GPIOB
#define RFM_DIO_Pin GPIO_PIN_1
#define RFM_DIO_GPIO_Port GPIOB
#define RFM_DIO_EXTI_IRQn EXTI1_IRQn
#define DC_MOTOR_EN3_4_Pin GPIO_PIN_10
#define DC_MOTOR_EN3_4_GPIO_Port GPIOB
#define RFM_SELECT_Pin GPIO_PIN_12
#define RFM_SELECT_GPIO_Port GPIOB
#define ELECTROMAGNET_Pin GPIO_PIN_3
#define ELECTROMAGNET_GPIO_Port GPIOB
