triflicacid/remote-submersible/code/on-board/main.h

#ifndef _MAIN_H_
#define _MAIN_H_

#include "shared/dc-motor.h"
#include "shared/lora.h"
#include "shared/stepper-motor-event.h"

// LoRa transmission device
extern lora_t g_lora;

// DC motor: primary propeller
extern dc_motor_t g_primary_motor;

// DC motor: secondary propeller
extern dc_motor_t g_secondary_motor;

// event for the ballast stepper motor
extern stepper_event_t g_ballast;

void setup(void);

void loop(void);

#endif
