triflicacid/remote-submersible/code/off-board/main.h

#ifndef _MAIN_H_
#define _MAIN_H_

#include "shared/7-segment.h"
#include "shared/lora.h"

// data type of DMA used by ADC1
typedef uint16_t dma_t;

// four digit 7-segment display
extern display_t g_display;

// LoRa transmission device
extern lora_t g_lora;

// ADC results from joystick
extern volatile uint32_t g_joystick_data[2];

void setup(void);

void loop(void);

#endif
