triflicacid/remote-submersible/code/dock/globals.h

#ifndef _GLOBALS_H_
#define _GLOBALS_H_

#include "shared/lora.h"
#include "shared/tm1637.h"

// four digit 7-segment display
extern tm1637_t g_display;

// LoRa transmission device
extern lora_t g_lora;

#endif
