triflicacid/remote-submersible/code/tests/test-stepper/Core/Src/main.c

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
/* Includes ------------------------------------------------------------------*/
#include "main.h"

/* USER CODE BEGIN Includes */
#include "Custom/stepper-motor.h"
/* USER CODE END Includes */


/* USER CODE BEGIN PV */
stepper_motor_t stepper;
uint8_t microstep_count = 8; // number of microsteps in one full step
bool forwards = true;
int counter = 0;
/* USER CODE END PV */

void SystemClock_Config(void);
static void MX_GPIO_Init(void);
/* USER CODE BEGIN 0 */
void setup(void) {
	stepper_motor_init(&stepper, GPIOC, (uint16_t[4]) { StepperBlack_Pin, StepperBlue_Pin, StepperGreen_Pin, StepperRed_Pin }, STEPPER_MOTOR_HALF_DRIVE);
	//microstep_count = stepper_motor_microstep_count(&stepper);
}

void loop(void) {
	counter++;

	if (counter > 250) {
		counter = 0;
		forwards = !forwards;
		stepper_motor_depower(&stepper); // IMPORTANT depower coils to prevent over-draw
		HAL_Delay(1000);
	}

	// perform one full step
	void (*microstep)(stepper_motor_t *) = forwards ? stepper_motor_microstep : stepper_motor_microstep_back;

	for (int i = 0; i < microstep_count; i++) {
		microstep(&stepper);
		HAL_Delay(1);
	}
}
/* USER CODE END 0 */

/**
  * @brief  The application entry point.
  * @retval int
  */
int main(void)
{

  /* MCU Configuration--------------------------------------------------------*/

  /* Reset of all peripherals, Initializes the Flash interface and the Systick. */
  HAL_Init();

  /* Configure the system clock */
  SystemClock_Config();

  /* Initialize all configured peripherals */
  MX_GPIO_Init();
  /* USER CODE BEGIN 2 */
  setup();
  /* USER CODE END 2 */

  /* Infinite loop */
  /* USER CODE BEGIN WHILE */
  while (1)
  {
	loop();
    /* USER CODE END WHILE */

    /* USER CODE BEGIN 3 */
  }
  /* USER CODE END 3 */
}

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
