triflicacid/remote-submersible/code/tests/stm/Core/Src/main.c

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
/* Includes ------------------------------------------------------------------*/
#include "main.h"

TIM_HandleTypeDef htim6;
TIM_HandleTypeDef htim8;

UART_HandleTypeDef huart2;

void SystemClock_Config(void);
static void MX_GPIO_Init(void);
static void MX_USART2_UART_Init(void);
static void MX_TIM8_Init(void);
static void MX_TIM6_Init(void);
/* USER CODE BEGIN 0 */
static const int step_delay = 500;


void delay_us(uint32_t us)
{
	for (int i = 0; i < us; i++){
		HAL_TIM_Base_Start(&htim6);
		HAL_TIM_Base_Stop(&htim6);
	}
}

void turn_cw(unsigned int steps){
	HAL_GPIO_WritePin(BLUE_GPIO_Port, BLUE_Pin, GPIO_PIN_SET);
	  HAL_GPIO_WritePin(ORANGE_GPIO_Port, ORANGE_Pin, GPIO_PIN_RESET);
	  HAL_GPIO_WritePin(YELLOW_GPIO_Port, YELLOW_Pin, GPIO_PIN_SET);
	  HAL_GPIO_WritePin(PINK_GPIO_Port, PINK_Pin, GPIO_PIN_SET);

	  for (int i = 0; i<steps; i++){
	delay_us(step_delay);
	  //HAL_Delay(1);
	  HAL_GPIO_WritePin(YELLOW_GPIO_Port, YELLOW_Pin, GPIO_PIN_RESET);
	  delay_us(step_delay);
	  //HAL_Delay(1);
	  HAL_GPIO_WritePin(ORANGE_GPIO_Port, ORANGE_Pin, GPIO_PIN_SET);
	  delay_us(step_delay);
	  //HAL_Delay(1);
	  HAL_GPIO_WritePin(PINK_GPIO_Port, PINK_Pin, GPIO_PIN_RESET);
	  delay_us(step_delay);
	  //HAL_Delay(1);
	  HAL_GPIO_WritePin(YELLOW_GPIO_Port, YELLOW_Pin, GPIO_PIN_SET);
	  delay_us(step_delay);
	  //HAL_Delay(1);
	  HAL_GPIO_WritePin(BLUE_GPIO_Port, BLUE_Pin, GPIO_PIN_RESET);
	  delay_us(step_delay);
	  //HAL_Delay(1);
	  HAL_GPIO_WritePin(PINK_GPIO_Port, PINK_Pin, GPIO_PIN_SET);
	  delay_us(step_delay);
	  //HAL_Delay(1);
	  HAL_GPIO_WritePin(ORANGE_GPIO_Port, ORANGE_Pin, GPIO_PIN_RESET);
	  delay_us(step_delay);
	  //HAL_Delay(1);
	  HAL_GPIO_WritePin(BLUE_GPIO_Port, BLUE_Pin, GPIO_PIN_SET);
	  }
}

void turn_acw(unsigned int steps){
	HAL_GPIO_WritePin(BLUE_GPIO_Port, BLUE_Pin, GPIO_PIN_RESET);
	  HAL_GPIO_WritePin(ORANGE_GPIO_Port, ORANGE_Pin, GPIO_PIN_RESET);
	  HAL_GPIO_WritePin(YELLOW_GPIO_Port, YELLOW_Pin, GPIO_PIN_SET);
	  HAL_GPIO_WritePin(PINK_GPIO_Port, PINK_Pin, GPIO_PIN_SET);

	  for (int i = 0; i<steps; i++){
	delay_us(step_delay);
	  //HAL_Delay(1);
	  HAL_GPIO_WritePin(ORANGE_GPIO_Port, ORANGE_Pin, GPIO_PIN_SET);
	  delay_us(step_delay);
	  //HAL_Delay(1);
	  HAL_GPIO_WritePin(PINK_GPIO_Port, PINK_Pin, GPIO_PIN_RESET);
	  delay_us(step_delay);
	  //HAL_Delay(1);
	  HAL_GPIO_WritePin(BLUE_GPIO_Port, BLUE_Pin, GPIO_PIN_SET);
	  delay_us(step_delay);
	  //HAL_Delay(1);
	  HAL_GPIO_WritePin(YELLOW_GPIO_Port, YELLOW_Pin, GPIO_PIN_RESET);
	  delay_us(step_delay);
	  //HAL_Delay(1);
	  HAL_GPIO_WritePin(PINK_GPIO_Port, PINK_Pin, GPIO_PIN_SET);
	  delay_us(step_delay);
	  //HAL_Delay(1);
	  HAL_GPIO_WritePin(ORANGE_GPIO_Port, ORANGE_Pin, GPIO_PIN_RESET);
	  delay_us(step_delay);
	  //HAL_Delay(1);
	  HAL_GPIO_WritePin(YELLOW_GPIO_Port, YELLOW_Pin, GPIO_PIN_SET);
	  delay_us(step_delay);
	  //HAL_Delay(1);
	  HAL_GPIO_WritePin(BLUE_GPIO_Port, BLUE_Pin, GPIO_PIN_RESET);
	  }
}




/* USER CODE END 0 */

/**
  * @brief  The application entry point.
  * @retval int
  */
int main(void)
{

  /* MCU Configuration--------------------------------------------------------*/

  /* Reset of all peripherals, Initializes the Flash interface and the Systick. */
  HAL_Init();

  /* Configure the system clock */
  SystemClock_Config();

  /* Initialize all configured peripherals */
  MX_GPIO_Init();
  MX_USART2_UART_Init();
  MX_TIM8_Init();
  MX_TIM6_Init();
  /* USER CODE BEGIN 2 */
  HAL_TIM_PWM_Start(&htim8, TIM_CHANNEL_1);
  HAL_TIM_Base_Init(&htim6);

  uint16_t dutyCycle = HAL_TIM_ReadCapturedValue(&htim8, TIM_CHANNEL_1);
  dutyCycle = dutyCycle/ 1.8;
  __HAL_TIM_SET_COMPARE(&htim8, TIM_CHANNEL_1, dutyCycle);

  HAL_GPIO_WritePin(BLUE_GPIO_Port, BLUE_Pin, GPIO_PIN_SET);
  	  HAL_GPIO_WritePin(ORANGE_GPIO_Port, ORANGE_Pin, GPIO_PIN_RESET);
  	  HAL_GPIO_WritePin(YELLOW_GPIO_Port, YELLOW_Pin, GPIO_PIN_SET);
  	  HAL_GPIO_WritePin(PINK_GPIO_Port, PINK_Pin, GPIO_PIN_SET);


  /* USER CODE END 2 */

  /* Infinite loop */
  /* USER CODE BEGIN WHILE */
  while (1)
  {
    /* USER CODE END WHILE */

    /* USER CODE BEGIN 3 */
	  turn_cw(100);
	  turn_acw(100);

		//HAL_TIM_PWM_Start(&htim8, TIM_CHANNEL_1);
	  //HAL_GPIO_WritePin(LD2_GPIO_Port, LD2_Pin, GPIO_PIN_SET);
	  //HAL_Delay(1000);
	  //HAL_GPIO_WritePin(LD2_GPIO_Port, LD2_Pin, GPIO_PIN_RESET);
	  //HAL_Delay(1000);



//	  while(1) {
//		  while(dutyCycle < __HAL_TIM_GET_AUTORELOAD(&htim8)) {
//			  dutyCycle += 5;
//			  __HAL_TIM_SET_COMPARE(&htim8, TIM_CHANNEL_1, dutyCycle);
//			  HAL_Delay(0);
//		  }
//
//		  while(dutyCycle > 0) {
//			  dutyCycle -= 5;
//			  __HAL_TIM_SET_COMPARE(&htim8, TIM_CHANNEL_1, dutyCycle);
//			  HAL_Delay(0);
//		  }
//	  }

  }
  /* USER CODE END 3 */
}

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
