triflicacid/remote-submersible/(commit log)

2024-07-16 Added off-board controller schematic
    [off-board-controller.kicad_pcb, off-board-controller.kicad_sch]
2024-07-16 off-board: set up 7-segment display
2024-07-16 off-board: set up LoRa device
2024-07-16 off-board: added structure of actions to implement
2024-07-16 off-board: added GPIO_EXTI callback
2024-07-16 off-board: implemented action_ballast
2024-07-16 on-board: initialise LoRa device
2024-07-17 entered initial version of pcb design
    [electromagnet.kicad_sch, mcu.kicad_sch, motor.kicad_sch, power.kicad_sch, radio.kicad_sch, sub.kicad_pcb, sub.kicad_sch]
2024-07-17 new version, and ltspice for electromagnet
    [electromagnet.kicad_sch, motor.kicad_sch, sub.kicad_pcb]
2024-07-17 Added library stepper-motor
2024-07-17 bug fixes and other small changes
    [actions.c, actions.h, stepper-motor.c, timed-events.c, timed-events.h]
2024-07-17 timed-events: remove malloc, made fixed-length array. Added support for multiple event arrays.
    [timed-events.c, timed-events.h]
2024-07-17 Added stepper-event library
2024-07-17 off-board: hardcode internal code, display downloaded code on receive
2024-07-18 changed size of electrolytic capacitors
    [electromagnet.kicad_sch, power.kicad_sch, sub.kicad_pcb]
2024-07-18 off-board: added joystick control
2024-07-18 updated names of components on schematic
    [power.kicad_sch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]
2024-07-18 started making a new version of off board controller
    [controller.kicad_pcb, controller.kicad_sch, io.kicad_sch, mcu.kicad_sch, power.kicad_sch, radio.kicad_sch]
2024-07-18 updated on-board schematic with changes
    [electromagnet.kicad_sch, mcu.kicad_sch, motor.kicad_sch, power.kicad_sch, radio.kicad_sch, sub.kicad_pcb]
2024-07-18 some layout updates
    [sub.kicad_pcb]
2024-07-19 off-board: added LoRa communication
2024-07-19 off-board: remove unused second timer
2024-07-19 off-board: remove redundant check in joystick_event_callback
2024-07-19 Added tri-state-switch
2024-07-19 off-board: added depth prediction
2024-07-19 created new version of layout
    [sub.kicad_pcb]
2024-07-19 updated silkscreen
    [sub.kicad_pcb]
2024-07-19 off-board: added STM32CubeMX configuration
2024-07-19 off-board: modified constants to reflect chip configuration
2024-07-19 off-board: fixed ADC-DMA logic
    [7-segment.h, actions.c, main.c, main.h]
2024-07-19 lora: added function to maximise a device's output power
2024-07-19 bug with stack allocation of opaque types (made types visible)
    [7-segment.c, 7-segment.h, lora.c, lora.h, stepper-motor.c, stepper-motor.h]
2024-07-19 Added dc-motor library
2024-07-19 on-board: added STM32CubeMX configuration
2024-07-19 on-board: updated schematic to match STM32 confighuration
    [electromagnet.kicad_sch, mcu.kicad_sch, motor.kicad_sch, power.kicad_sch, radio.kicad_sch]
2024-07-20 off-board: changed location of radio DIO0 and RST pins
2024-07-20 off-board: created schematic
    [controller.kicad_pcb, controller.kicad_sch, io.kicad_sch, mcu.kicad_sch, power.kicad_sch, radio.kicad_sch]
2024-07-20 off-board: added SWCLK and SWDIO needed for the programmer, resolved conflicts
    [controller.kicad_pcb, controller.kicad_sch, mcu.kicad_sch]
2024-07-20 on-board: added constants, set up timers, set up LoRa
2024-07-20 off-board: removed timed event usage, created seperate timer for depth prediction
2024-07-20 on-board: send & request code handlers
2024-07-20 on-board: release escape pod logic
2024-07-20 on-board: logic to operate propeller DC motors
2024-07-20 dc-motor: cache velocity, guard against repetitious actions
2024-07-20 on-board: logic to operate ballast stepper motor, library fixes
    [actions.c, actions.h, constants.h, main.c, main.h, stepper-motor.c, stepper-motor.h]
2024-07-22 started new version
    [controller.kicad_pcb, controller.kicad_sch, electromagnet.kicad_sch, mcu.kicad_sch, motor.kicad_sch, power.kicad_sch, radio.kicad_sch]
2024-07-22 produced version with 2 0V floods
    [controller.kicad_pcb, controller.kicad_sch, mcu.kicad_sch]
2024-07-22 on-board: pin changes
2024-07-22 added a keepout zone
    [controller.kicad_pcb]
2024-07-23 changed 7 segment library to 36-pin
2024-07-23 finished footprints, schematic, and started layout
    [controller.kicad_pcb, controller.kicad_sch, io.kicad_sch, mcu.kicad_sch, power.kicad_sch, radio.kicad_sch]
2024-07-24 made plan for layout
    [controller.kicad_pcb]
2024-07-24 added some leds to controller
    [controller.kicad_pcb, io.kicad_sch]
2024-07-27 produced first draft of layout design
    [controller.kicad_pcb, io.kicad_sch, mcu.kicad_sch, power.kicad_sch]
2024-07-27 redesigned layout
    [controller.kicad_pcb]
2024-07-28 first draft of off- board layout
    [controller.kicad_pcb]
2024-07-29 changed size of holes on buck footprint
    [controller.kicad_pcb]
2024-07-29 off-board: changed depth estimation timer to 4Hz
2024-07-29 changed footprint for electrolytic capacitors
    [bom.csv, controller.kicad_pcb]
2024-07-29 added a bom and edited layout
    [bom.csv, controller.kicad_pcb, motor.kicad_sch, power.kicad_sch]
2024-07-31 submitted version for checking
    [bom.csv, controller.kicad_pcb, power.kicad_sch]
2024-08-01 updated footprints for through hole components with long legs
    [controller.kicad_pcb]
2024-08-01 generated gerber
    [controller-B_Cu.gbr, controller-B_Mask.gbr, controller-B_Paste.gbr, controller-B_Silkscreen.gbr, controller-Edge_Cuts.gbr, controller-F_Cu.gbr, controller-F_Mask.gbr, controller-F_Paste.gbr]
2024-08-01 off-board: change tri-state switch behaviour to match toggle functionality
2024-08-06 Added dock schematic
    [dock.kicad_sch, io.kicad_sch, mcu.kicad_sch, power.kicad_sch, radio.kicad_sch]
2024-08-06 off-board: segment movement indicator
2024-08-08 added debouncing code for buttons/switch
2024-08-12 off-board: change ADC from circular to normal mode
2024-08-12 added mcp23s17 library for interfacing with the pin extender
2024-08-13 off-board: added 7-segment library
2024-08-15 off-board: generated chip source code
2024-08-15 on-board: generated chip source code
2024-08-29 files from vanilla laptop
    [bom.csv, bom_off.csv, controller.kicad_pcb]
2024-08-30 changes to simulation for electromagnet circuit
2024-09-04 Added various tests, started work on off-board controller
    [bom.csv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]
2024-09-05 pinout for on-board
2024-09-05 stepper test had errors, corrected by setting microsteps to 8
    [main.c]
2024-09-06 new lora off-board file
2024-09-06 Added test for LoRa off-board with new library
2024-09-06 fixed radio on integrated
    [main.c]
2024-09-07 Added dock code
    [io.kicad_sch, mcu.kicad_sch]
2024-09-07 reset timer for each release electromagnet (stop timer does not reset), though does not work properly on startup
    [actions.c, main.c]
2024-09-07 fixed startup issues for timer, is now very reliable
    [actions.c, integrates-on-board.ioc, main.c]
2024-09-07 code is more reliable when adding appropriate delays in spi communication (on-board)
2024-09-07 copied delays into off-board
2024-09-07 code to stop immediate triggering of timer
2024-09-07 code to stop immediate interrupt for stepper (as in electromagnet)
2024-09-07 disable interrupts for mcp spi
2024-09-08 attempted to fix dma. but still doesn't work (only does one conversion)
    [integrates-off-board.ioc, main.c]
2024-09-08 changed setting adc dma, adcs now continuously convert
2024-09-08 depower all stepper pins after movement
2024-09-08 solution for entering hard fault on motor control, but do not understand why it works, solution is untidy
2024-09-08 updated range adcs are mapped to to -1 to 1, also updated some max and min adc values
2024-09-08 pwm uses timer 2 not 3
2024-09-09 Small changes to on- and off-board controller
2024-09-09 increases off-board timer to every 0.4s, makes code not get stuck in adding actions
    [integrates-on-board.ioc]
2024-09-09 increased prescalar of off-board timer
2024-09-10 Fixed ADC check issue overstraining the chip
    [actions.c, constants.h, main.c]
